Loredati-svg/ClockClock24/Hardware/Controller/ClockClock24.pdf

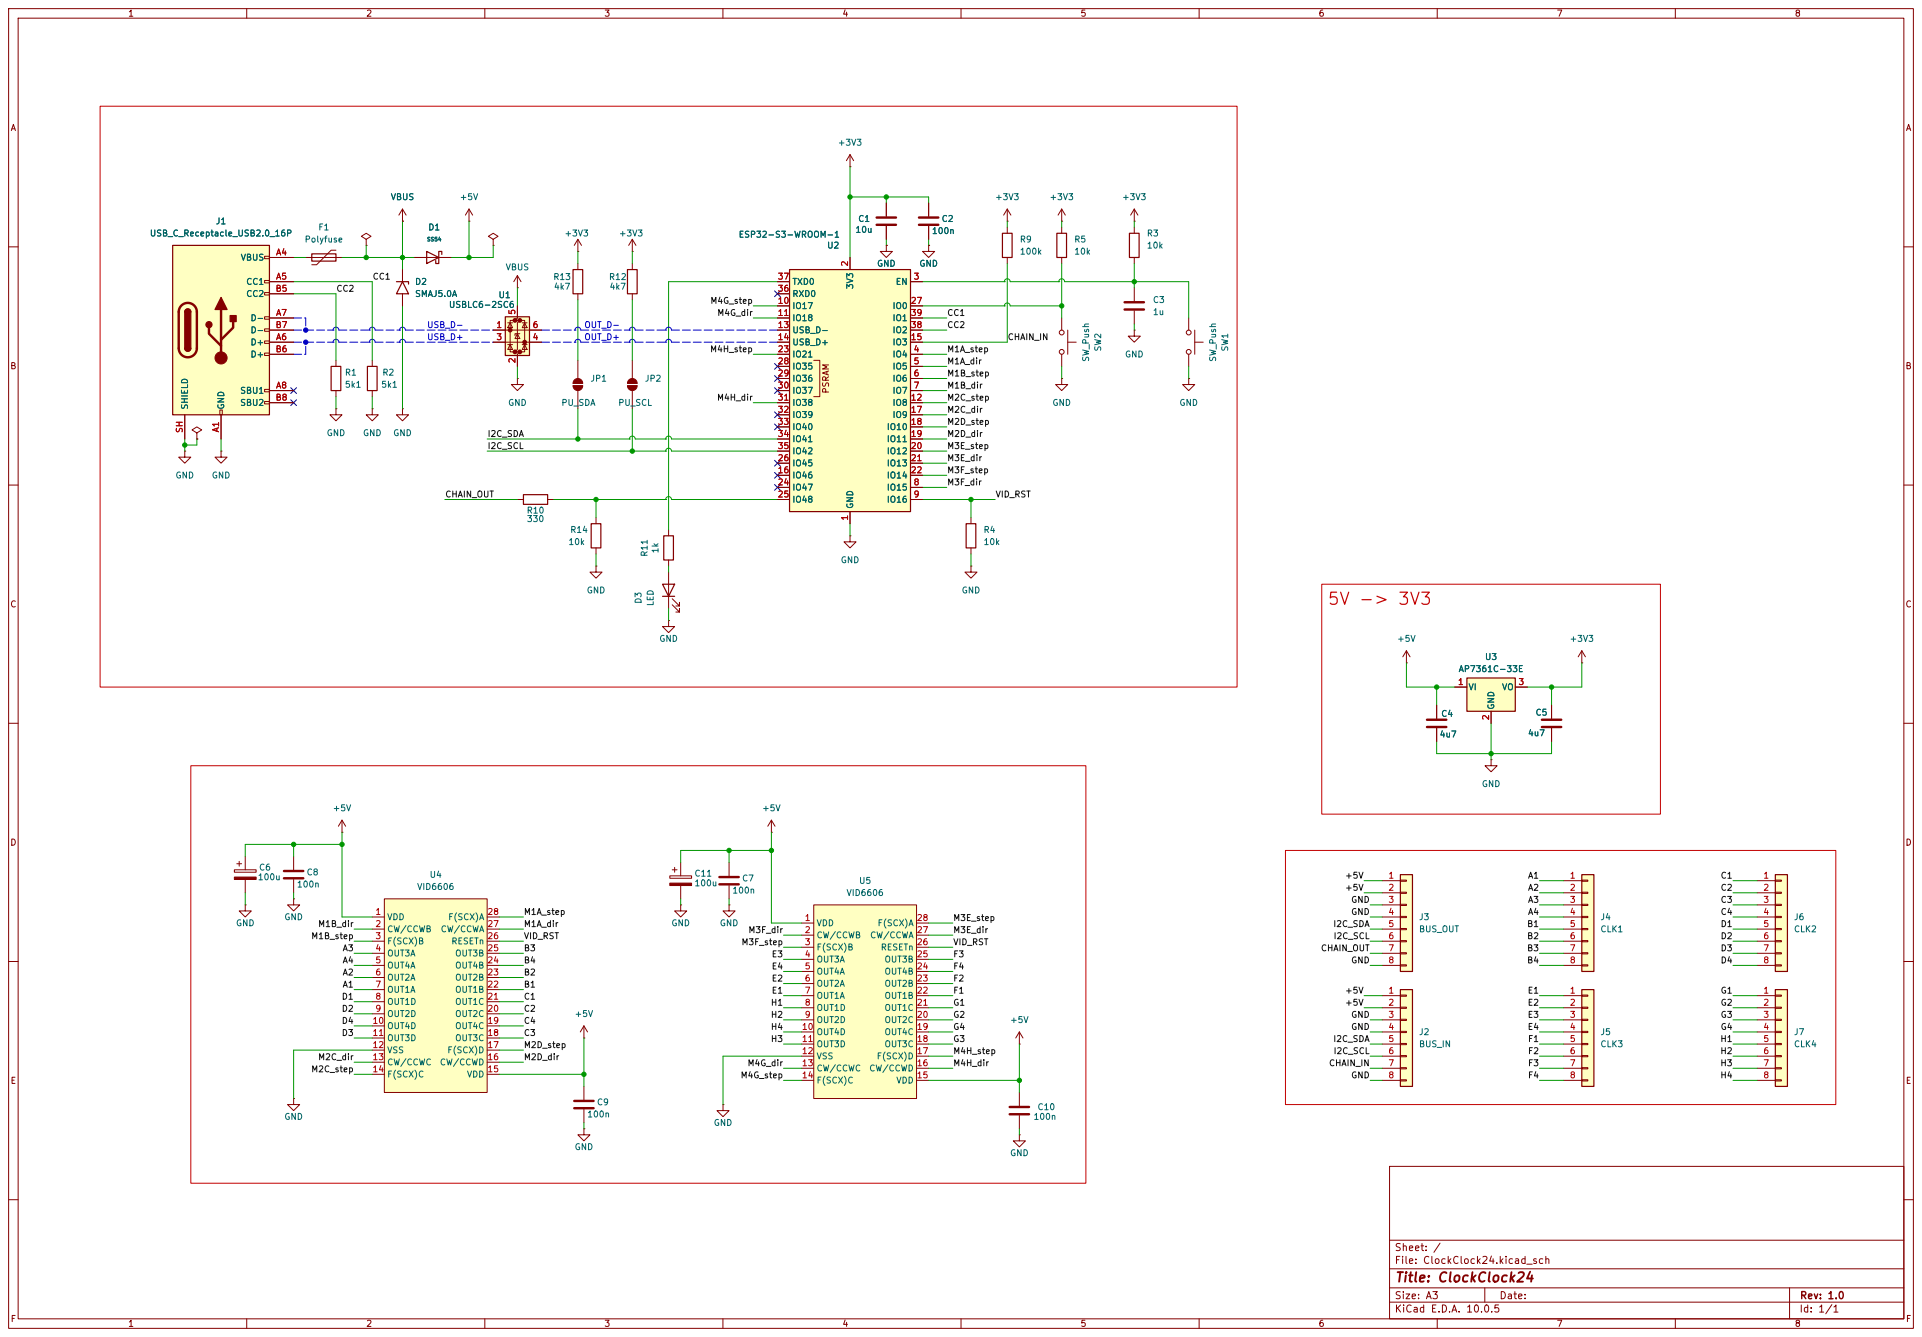
[picture p3: page 1]

100n GND U2
IO2 38 IO1 39 U2 IO9 17 IO9 17 IO10 18 IO10 18 IO11 19 IO11 19 IO12 20 IO12 20 IO13 21 IO13 21 IO14 22 IO14 22

Size: A3 | Rev: 1.0 | F Date:
KiCad E.D.A. 10.0.5 | Id: 1/1
