Loredati-svg/ClockClock24/Hardware/Motor_PCB/Motor_PCB.kicad_pcb

## KiCad design Hardware/Motor_PCB/Motor_PCB.kicad_pcb (2026-10-29)

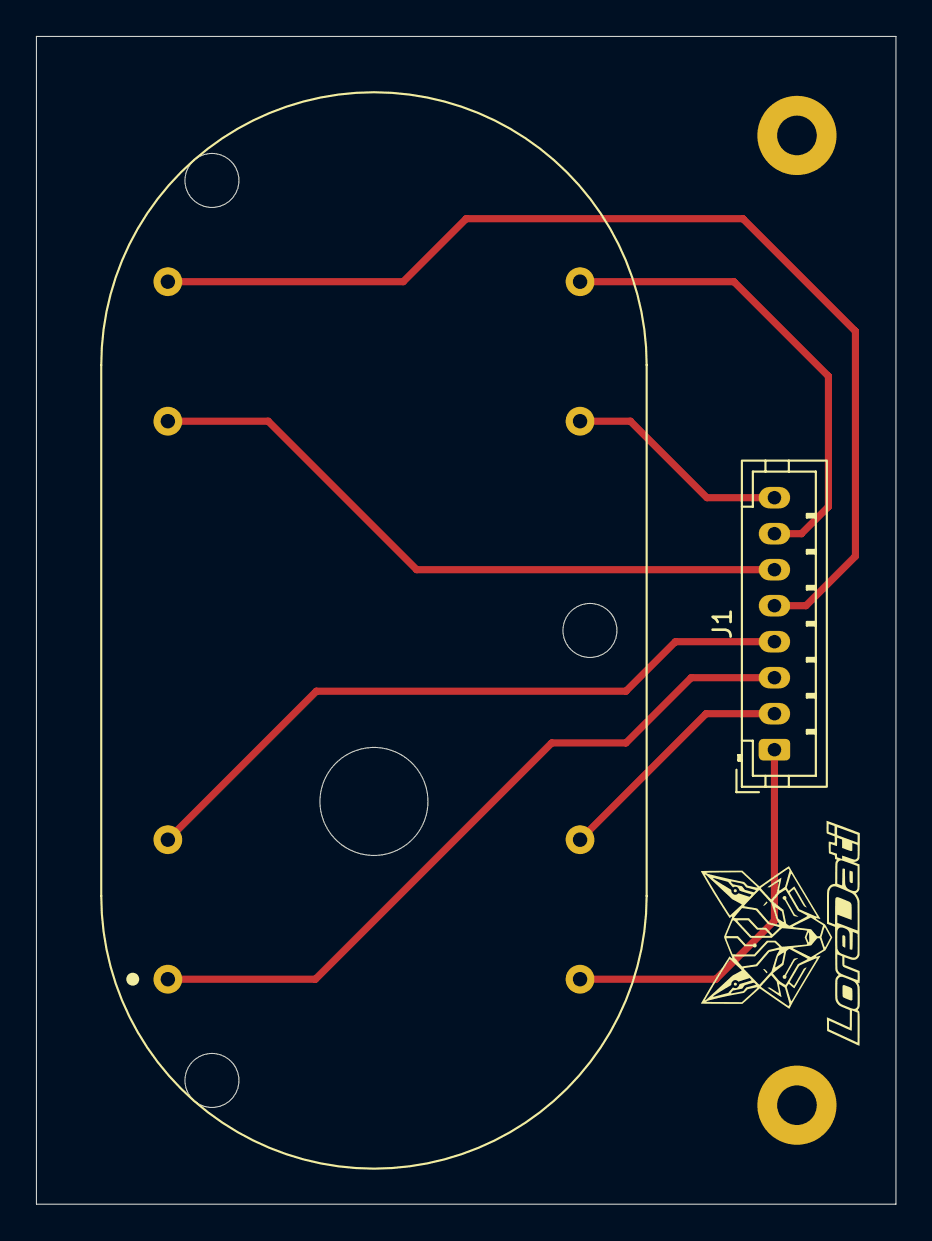
[picture p4: board Motor_PCB.kicad_pcb from above]

Board: 2 copper layers, 47.8 x 64.9 mm, 4 parts (0 on the bottom side), 8 nets.

Parts:
H1, H2: MountingHole; MountingHole_2.2mm_M2_Pad
J1: Conn_01x08; JST_PH_B8B-PH-K_1x08_P2.00mm_Vertical
M1: BKA30D-R5

Connections:
/M1_1: J1.4, M1.1 (M1_A+)
/M1_2: J1.3, M1.2 (M1_A-)
/M1_3: J1.1, M1.3 (M1_B+)
/M1_4: J1.2, M1.4 (M1_B-)
/M2_1: J1.8, M1.5 (M2_A+)
/M2_2: J1.7, M1.6 (M2_A-)
/M2_3: J1.5, M1.7 (M2_B+)
/M2_4: J1.6, M1.8 (M2_B-)
