Loredati-svg/ClockClock24/Hardware/Controller/ClockClock24.kicad_pcb

## KiCad design Hardware/Controller/ClockClock24.kicad_pcb (2026-10-29)

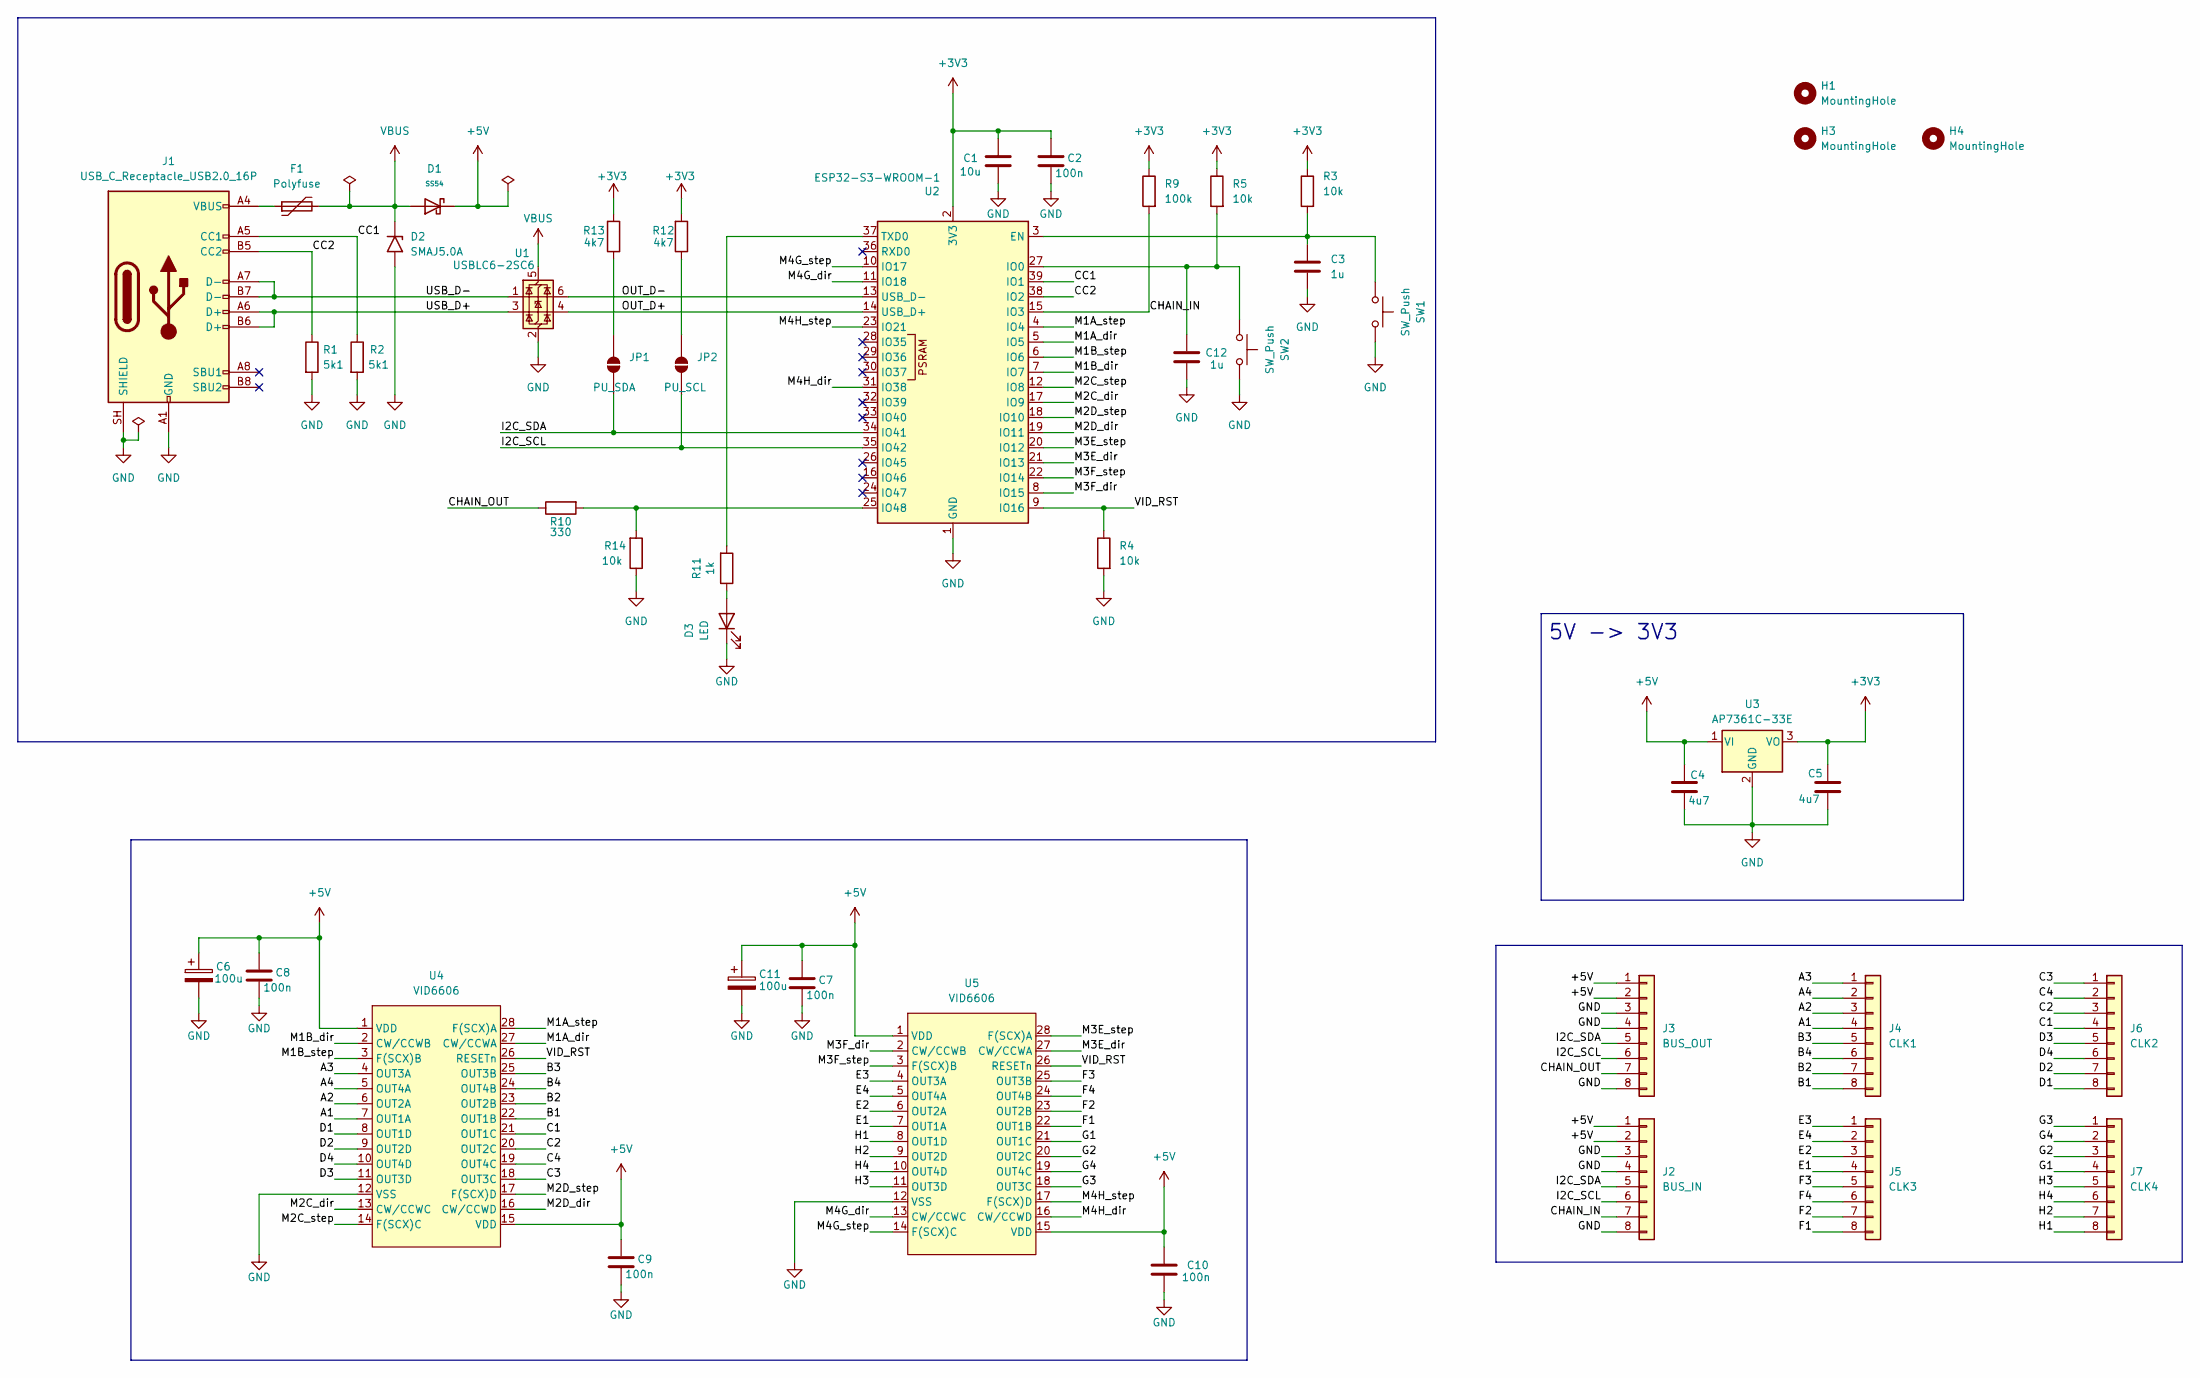
[picture p5: schematic ClockClock24.kicad_sch]

Parts:
C1: 10u; 0603; LCSC C19702
C2, C7, C8, C9, C10: 100n; 0603; LCSC C66501
C3, C12: 1u; 0603; LCSC C1592
C4, C5: 4u7; 0603; LCSC C19666
C6, C11: 100u; CP_Elec_6.3x5.4; LCSC C7469933
D1: SS54; D_SMA; Forward Voltage (Vf@If) 550mV@5A; Reverse Voltage (Vr) 40V; Part SS54; LCSC C22452
D2: SMAJ5.0A; D_SMA; LCSC C113952
D3: LED; 0603_pol; LCSC C22371297
F1: Polyfuse; Fuse_1206_3216Metric; LCSC C269119
H1, H3, H4: MountingHole; MountingHole_2.2mm_M2_Pad
J1: USB_C_Receptacle_USB2.0_16P; USB_C_Receptacle_HRO_TYPE-C-31-M-12; LCSC C165948
J2: BUS_IN; JST_XH_B8B-XH-A_1x08_P2.50mm_Vertical; LCSC C157972
J3: BUS_OUT; JST_XH_B8B-XH-A_1x08_P2.50mm_Vertical; LCSC C157972
J4: CLK1; JST_PH_B8B-PH-K_1x08_P2.00mm_Vertical; LCSC C157974
J5: CLK3; JST_PH_B8B-PH-K_1x08_P2.00mm_Vertical; LCSC C157974
J6: CLK2; JST_PH_B8B-PH-K_1x08_P2.00mm_Vertical; LCSC C157974
J7: CLK4; JST_PH_B8B-PH-K_1x08_P2.00mm_Vertical; LCSC C157974
JP1: PU_SDA; SolderJumper-2_P1.3mm_Open_RoundedPad1.0x1.5mm
JP2: PU_SCL; SolderJumper-2_P1.3mm_Open_RoundedPad1.0x1.5mm
R1, R2: 5k1; 0603; LCSC C23186
R3, R4, R5, R14: 10k; 0603; LCSC C98220
R9: 100k; 0603; LCSC C14675
R10: 330; 0603; LCSC C105881
R11: 1k; 0603; LCSC C22548
R12, R13: 4k7; 0603; LCSC C99782
SW1, SW2: SW_Push; SW_SPST_B3U-1000P; LCSC C231329
U1: USBLC6-2SC6; SOT-23-6; LCSC C7519
U2: ESP32-S3-WROOM-1; LCSC C2913198
U3: AP7361C-33E; SOT-223-3_TabPin2; LCSC C500795
U4, U5: VID6606; SOIC-28W_7.5x17.9mm_P1.27mm

Connections:
+3V3: C1.1, C2.1, C5.1, R3.1, R5.1, R9.1, R12.2, R13.2, U2.2 (3V3), U3.3 (VO)
+5V: C4.1, C6.1, C7.1, C8.1, C9.1, C10.1, C11.1, D1.1, J2.1, J2.2, J3.1, J3.2, U3.1 (VI), U4.1 (VDD), U4.15 (VDD), U5.1 (VDD), U5.15 (VDD)
/A1: J4.4, U4.7 (OUT1A)
/A2: J4.3, U4.6 (OUT2A)
/A3: J4.1, U4.4 (OUT3A)
/A4: J4.2, U4.5 (OUT4A)
/B1: J4.8, U4.22 (OUT1B)
/B2: J4.7, U4.23 (OUT2B)
/B3: J4.5, U4.25 (OUT3B)
/B4: J4.6, U4.24 (OUT4B)
/C1: J6.4, U4.21 (OUT1C)
/C2: J6.3, U4.20 (OUT2C)
/C3: J6.1, U4.18 (OUT3C)
/C4: J6.2, U4.19 (OUT4C)
/CC1: J1.A5 (CC1), R2.1, U2.39 (IO1)
/CC2: J1.B5 (CC2), R1.1, U2.38 (IO2)
/CHAIN_IN: J2.7, R9.2, U2.15 (IO3)
/CHAIN_OUT: J3.7, R10.1
/D1: J6.8, U4.8 (OUT1D)
/D2: J6.7, U4.9 (OUT2D)
/D3: J6.5, U4.11 (OUT3D)
/D4: J6.6, U4.10 (OUT4D)
/E1: J5.4, U5.7 (OUT1A)
/E2: J5.3, U5.6 (OUT2A)
/E3: J5.1, U5.4 (OUT3A)
/E4: J5.2, U5.5 (OUT4A)
/F1: J5.8, U5.22 (OUT1B)
/F2: J5.7, U5.23 (OUT2B)
/F3: J5.5, U5.25 (OUT3B)
/F4: J5.6, U5.24 (OUT4B)
/G1: J7.4, U5.21 (OUT1C)
/G2: J7.3, U5.20 (OUT2C)
/G3: J7.1, U5.18 (OUT3C)
/G4: J7.2, U5.19 (OUT4C)
/H1: J7.8, U5.8 (OUT1D)
/H2: J7.7, U5.9 (OUT2D)
/H3: J7.5, U5.11 (OUT3D)
/H4: J7.6, U5.10 (OUT4D)
/I2C_SCL: J2.6, J3.6, JP2.1 (A), U2.35 (IO42)
/I2C_SDA: J2.5, J3.5, JP1.1 (A), U2.34 (IO41)
/M1A_dir: U2.5 (IO5), U4.27 (CW/CCWA)
/M1A_step: U2.4 (IO4), U4.28 (F(SCX)A)
/M1B_dir: U2.7 (IO7), U4.2 (CW/CCWB)
/M1B_step: U2.6 (IO6), U4.3 (F(SCX)B)
/M2C_dir: U2.17 (IO9), U4.13 (CW/CCWC)
/M2C_step: U2.12 (IO8), U4.14 (F(SCX)C)
/M2D_dir: U2.19 (IO11), U4.16 (CW/CCWD)
/M2D_step: U2.18 (IO10), U4.17 (F(SCX)D)
/M3E_dir: U2.21 (IO13), U5.27 (CW/CCWA)
/M3E_step: U2.20 (IO12), U5.28 (F(SCX)A)
/M3F_dir: U2.8 (IO15), U5.2 (CW/CCWB)
/M3F_step: U2.22 (IO14), U5.3 (F(SCX)B)
/M4G_dir: U2.11 (IO18), U5.13 (CW/CCWC)
/M4G_step: U2.10 (IO17), U5.14 (F(SCX)C)
/M4H_dir: U2.31 (IO38), U5.16 (CW/CCWD)
/M4H_step: U2.23 (IO21), U5.17 (F(SCX)D)
/OUT_D+: U1.4 (I/O2), U2.14 (USB_D+)
/OUT_D-: U1.6 (I/O1), U2.13 (USB_D-)
/USB_D+: J1.A6 (D+), J1.B6 (D+), U1.3 (I/O2)
/USB_D-: J1.A7 (D-), J1.B7 (D-), U1.1 (I/O1)
/VID_RST: R4.1, U2.9 (IO16), U4.26 (RESETn), U5.26 (RESETn)
GND: C1.2, C2.2, C3.2, C4.2, C5.2, C6.2, C7.2, C8.2, C9.2, C10.2, C11.2, C12.2, D2.2 (A2), D3.1 (K), J1.A1 (GND), J1.A12 (GND), J1.B1 (GND), J1.B12 (GND), J1.SH (SHIELD), J2.3, J2.4, J2.8, J3.3, J3.4, J3.8, R1.2, R2.2, R4.2, R14.1, SW1.2, SW2.2, U1.2 (GND), U2.1 (GND), U2.40 (GND), U2.41 (GND), U3.2 (GND), U4.12 (VSS), U5.12 (VSS)
unnamed: D3.2 (A), R11.1
unnamed: F1.1, J1.A4 (VBUS), J1.A9 (VBUS), J1.B4 (VBUS), J1.B9 (VBUS)
unnamed: JP1.2 (B), R13.1
unnamed: JP2.2 (B), R12.1
unnamed: C3.1, R3.2, SW1.1, U2.3 (EN)
unnamed: C12.1, R5.2, SW2.1, U2.27 (IO0)
unnamed: R10.2, R14.2, U2.25 (IO48)
unnamed: R11.2, U2.37 (TXD0)
VBUS: D1.2, D2.1 (A1), F1.2, U1.5 (VBUS)

Notes on the sheet:
5V -> 3V3

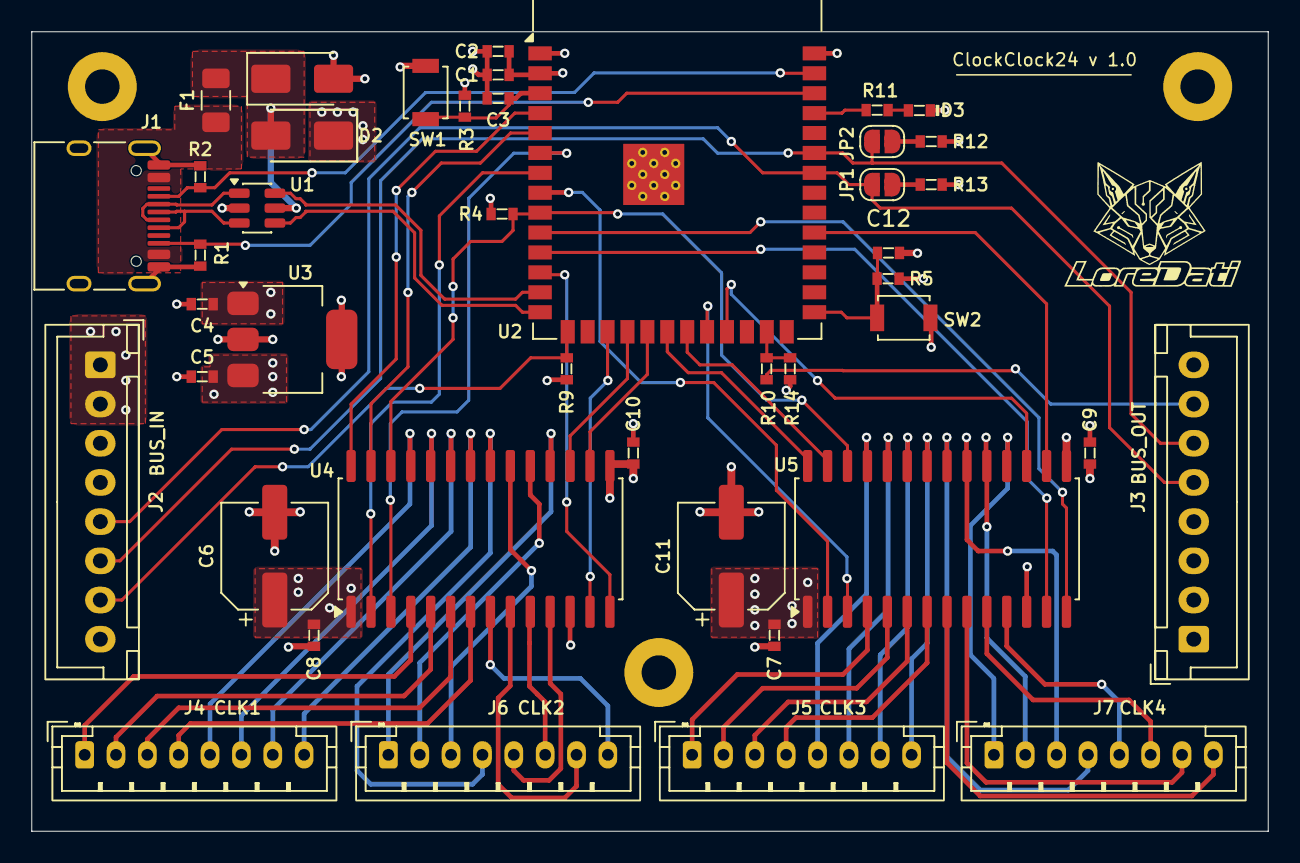
[picture p6: board ClockClock24.kicad_pcb from above]

Board: 4 copper layers, 78.9 x 51.0 mm, 46 parts (0 on the bottom side), 71 nets.
