Loredati-svg/ClockClock24/(commit log)

2026-10-27 Add hardware, firmware, diagrams and Kicad_Libs submodule
    [ClockClock24.kicad_pcb, ClockClock24.kicad_sch]
2026-10-27 added images
    [ClockClock24.kicad_pcb]
2026-10-27 Update README with badges and board details
    Added status and hardware badges, updated controller and motor board sections.
2026-10-28 Add Motor_PCB board and update Controller
    - New Motor_PCB KiCad project (motor-only board), linked to Kicad_Libs
    - Controller: schematic, PCB and project updates
    [ClockClock24.kicad_pcb, ClockClock24.kicad_sch, Motor_PCB.kicad_pcb, Motor_PCB.kicad_sch]
2026-10-29 Added Fab files, BOM and minor changes in layout
    [ClockClock24-B_Mask.gbr, ClockClock24-B_Paste.gbr, ClockClock24-B_Silkscreen.gbr, ClockClock24-Bot.gbr, ClockClock24-Edge_Cuts.gbr, ClockClock24-F_Mask.gbr, ClockClock24-F_Paste.gbr, ClockClock24-F_Silkscreen.gbr]
